jozuern/fw_alarm/(commit log)

2026-06-09 @ BOSS-925 Alarm-Waechter: PlatformIO-Projekt mit Bark-Anbindung
    - Firmware aus Einzel-Sketch in PlatformIO-/Arduino-IDE-kompatible Struktur refaktoriert
    - Secrets nach config.h ausgelagert (gitignored), config.example.h als Vorlage
    - Robustheit: WLAN-Reconnect, pro-Key-Retry, Selbsttest, Watchdog, NTP, optionaler 2. Eingang
    - Ausfuehrliches deutsches README + CLAUDE.md
    @
2026-06-09 @ Alarm-Ton alarm_fw.mp3 hinzufuegen + Import-Anleitung pro iPhone
    - alarm_fw.mp3 (eigener ~30s Sirenenton) ins Repo aufgenommen
    - README: Schritt-fuer-Schritt, wie der Ton in Bark auf JEDEM Empfaenger-iPhone
    importiert wird (Pflicht), inkl. 30s-Limit-Hinweis und Alternative
    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
2026-06-09 @ Umlaute korrigieren + Bark-Texte auf ASCII
    - Echte Umlaute (ä/ö/ü) in .gitignore, platformio.ini und README-Beispielausgabe
    - Bark-Notification kann keine Umlaute anzeigen: ALARM_BODY und Status-/Heartbeat-
    Texte bewusst auf ASCII (ae/ue/oe) umgestellt, mit erklärendem Kommentar
    - Konvention in CLAUDE.md dokumentiert
    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
    [boss925_alarm_bark.ino, config.example.h]
2026-06-17 Probealarm-Fenster: woechentlichen ILS-Test leise quittieren
    Ein Probealarm loest denselben Relaiskontakt aus wie ein echter Alarm.
    Im konfigurierbaren TESTALARM-Fenster (Standard Mi 18:55-19:10) geht daher
    kein lauter Broadcast an alle, sondern nur ein leiser Status-Ping an den
    Owner ("Probealarm erkannt"). inTestWindow() faellt ohne gueltige NTP-Zeit
    auf false zurueck (fail-safe: im Zweifel normal alarmieren).
    - config.example.h: TESTALARM_* Defaults
    - boss925_alarm_bark.ino: inTestWindow() + Gate in loop()
    - CLAUDE.md: Verhalten dokumentiert
    [boss925_alarm_bark.ino, config.example.h]
2026-06-17 README: DIN-Stecker konkretisieren + Pin-Findung per Multimeter
    Hardware-Anschluss praezisiert auf Basis recherchierter Fakten zum
    BOSS-925 / LGRA-Lader:
    - Teileliste: konkreter Bestellbegriff "DIN-Stecker 5-polig 180°
    Loetversion", Schraubklemm-Alternative, Hinweis auf 6-pol Mini-DIN
    bei neueren s.QUAD-Ladern.
    - Verkabelung: Lader-Familie statt nur "LGRA-Expert", Ausloese-
    Bedingung des Relais ergaenzt.
    - Pin-Findung vereinfacht: Pin 1 vs. Pin 3 ist egal (potenzialfreier
    Kontakt); entscheidend ist, die richtigen zwei von fuenf Stiften per
    Multimeter-Durchgangspruefung zu finden (nicht Pin 2/4 erwischen).
2026-07-07 NAS-Dashboard überarbeitet: Direktalarm, Empfängerverwaltung, Härtung
    Dashboard/PHP:
    - REAL ALARM läuft jetzt direkt vom NAS zu Bark (cURL, level=critical,
    pro Key isoliert mit Retry) - unabhängig von der ESP32-Kette.
    - Empfängerliste (Bark-Keys) im Dashboard pflegbar: versioniert in
    alarm_keys.json.php, neues api/keys.php; ESP32 synchronisiert per
    keys_version im Poll und persistiert die Liste im NVS.
    - Pending-Befehle verfallen per TTL (expired) und sind abbrechbar;
    Poll liefert nur aus, wenn der delivered-Zustand persistiert wurde.
    - Laufzeitdateien als *.php mit Guard-Zeile: Nginx (Web Station,
    ignoriert .htaccess) liefert sie nie mehr öffentlich aus.
    - Schreibfehler wer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
2026-07-07 Dashboard: Demo-Modus, Status-Tooltips, Lesebenutzer-Nachzügler
    Demo/Live-Schalter (Panel "Betriebsmodus", nur Admin): Im Demo-Modus gehen
    beide Alarmwege (ESP32-Relaisalarm und NAS-Direktalarm) nur an einen
    Test-Empfänger aus der gepflegten Liste. Ohne Firmware-Änderung umgesetzt:
    demo_mode.json im data_dir, effective_alarm_keys() in common.php speist
    api/keys.php und bark_send_alarm_all(); jeder Moduswechsel erhöht die
    keys_version, der ESP32 holt die Liste beim nächsten Poll. Warn-Banner mit
    Sync-Anzeige (ESP32- vs. NAS-Version), Demo-Empfänger nicht löschbar,
    NAS-Alarm-Body bekommt Zusatz [DEMO-MODUS].
    Statusfelder: ?-Tooltips mit Erklärung an jedem Wert, lesbare Formate
    (Uptime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
2026-07-07 Tooltip-Symbol als schlichtes (?) direkt hinter dem Feldtitel
    Der graue Kreis saß daneben und rutschte in eine eigene Zeile, weil
    ".field span { display:block }" spezifischer war als ".help". Jetzt
    gewinnt ".field span span.help" und das Symbol bleibt inline.
2026-07-07 Demo-Alarm exakt wie echter Alarm: [DEMO-MODUS]-Zusatz entfernt
    Ein Alarm im Demo-Modus soll sich in nichts vom echten unterscheiden
    (gleicher Text, Ton, Level) - nur die Empfaengerliste ist kuerzer.
    Der ESP32-Relaisalarm war ohnehin identisch; jetzt auch der
    NAS-Direktalarm.
2026-07-07 Repo für Veröffentlichung vorbereitet: keine Geheimnisse, MIT-Lizenz
    - Persönliche Empfänger-Onboarding-Anleitung (bark-anleitung.html + PDF)
    aus dem Tracking entfernt und via .gitignore ausgeschlossen (enthielt
    Name und Handynummer des Betreibers).
    - Login-Timing-Schutz-Hash in index.php durch einen frischen Wegwerf-Wert
    ersetzt (Decoy, verifiziert gegen nichts Reales).
    - Interne NAS-IP und Router-Modell aus config.example.h/SETUP.md
    generalisiert (Beispiel-IP 192.168.1.50, "am Router").
    - README aktualisiert: config.h wird aus der Vorlage angelegt (keine
    mitgelieferte config.h mehr behauptet), Demo-Modus, Lese-Benutzer und
    NAS-Offline-Wächter dokumentiert, Sicherheits-/Liz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
2026-07-07 Wächter erweitert: Demo-Erinnerung, Selbstüberwachung, relative Verlaufszeiten
    - cron/check_offline.php erinnert leise per Bark, wenn der Demo-Modus länger
    als demo_reminder_after_seconds (Default 4 h) aktiv bleibt (danach max.
    1x/Tag) - echte Alarme erreichen im Demo-Modus nur den Test-Empfänger.
    - Selbstüberwachung: jeder Wächter-Lauf schreibt last_run_at; das Dashboard
    zeigt "Offline-Wächter: zuletzt gelaufen vor X min" und warnt, wenn die
    DSM-Aufgabe fehlt oder seit >15 min nicht mehr läuft.
    - Verlauf zeigt junge Ereignisse relativ ("vor 5 min", absolute Zeit im
    Tooltip), berechnet mit Server-Zeit statt Browser-Uhr.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
2026-07-08 Bark-Warnung, wenn das NAS das Maschinen-Token ablehnt (HTTP 403)
    Antwortet das NAS auf einen beliebigen API-Aufruf mit 403, geht einmalig
    eine Status-Nachricht an den Owner (BARK_KEY_STATUS). Ohne diese Meldung
    fiel ein falscher Token-Hash in der config.php erst auf, wenn man zufällig
    aufs Dashboard schaute. Nach der nächsten erfolgreichen NAS-Antwort wird
    die Warnung wieder scharf; während alarmPending wird sie zurückgestellt
    (Alarmzustellung hat Vorrang).
2026-07-09 Arbeitsmodus: Stummschaltung pro Empfänger + Verlaufs-/Diagnose-Ausbau
    Kollegen können ihren Empfänger per persönlichem Kurzbefehl-Link
    (api/mute.php?key=<BARK_KEY>&state=on|off, z.B. iPhone-Automation beim
    Betreten/Verlassen der Arbeit) stummschalten: Der Alarm kommt weiterhin
    als Critical Alert an, aber mit volume=0 – lautlos, durchbricht trotzdem
    Stummschalter und Fokus. Beide Alarmwege respektieren das Flag
    (bark_send_alarm_one mit $muted; Firmware über alarmKeyMuted[], Sync via
    muted{i}-Zeilen in api/keys.php, NVS-persistiert, fehlend = laut).
    Sicherheitsnetz: Auto-Unmute nach mute_max_seconds (Default 12 h,
    expire_stale_mutes läuft in mute.php, keys.php, keys_list, vor jedem
    R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
2026-07-09 Sicherheit: data_dir standardmäßig außerhalb des Web-Roots
    Die Laufzeitdateien (u.a. Bark-Keys im Klartext) lagen per Default im
    Web-Root und waren nur durch die .php-Guard-Zeile geschützt - eine
    einzige, zerbrechliche Schicht. config.example.php und SETUP.md empfehlen
    jetzt einen Pfad außerhalb von /volume1/web (bewährt:
    /volume1/web_packages/fw_alarm_data); die Guard-Zeile bleibt als zweite
    Schicht. Live-NAS bereits umgestellt und alter Ordner entfernt.
2026-07-09 Probealarm-Fenster: Alarme mittwochs 18:55-19:05 leiser alarmieren
    Der wöchentliche ILS-Probealarm löst weiterhin den vollen Alarm aus (er
    testet damit die komplette Kette), geht aber nur noch mit halber
    Lautstärke raus: volume=5 statt volume=10. Text, Ton, level=critical und
    call=1 bleiben unverändert.
    Sicherungen gegen versehentlich leise Echtalarme:
    - gilt nur am Probealarm-Wochentag (PROBE_WEEKDAY, -1 = jeden Tag)
    - ohne gültige NTP-Zeit gilt immer die volle Lautstärke
    - die Lautstärke wird einmal bei der Erkennung in pendingVolume
    festgehalten, damit Nachsende-Runden nach Fensterende nicht laut werden
    Stumme Empfänger (Arbeitsmodus) bleiben bei volume=0. Der manuelle
    Dashboa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
2026-07-09 Dashboard: Hinweistexte kürzen
    Die Hinweise unter Empfängerliste, Demo-Modus und Befehls-Knöpfen waren
    sehr lang. Inhaltlich unverändert, nur knapper formuliert.
2026-07-10 Arbeitsmodus-Ausbau: Stumm-Lautstärke, Geheim-Links, Entwarnung, Mobile-UI
    - Stumm-Lautstärke pro Empfänger (0-10, Standard 0 = lautlos): im Dashboard
    einstellbar (keys_set_mute_volume), wirkt auf beide Alarmwege; keys.php
    liefert mutevol{i}, Firmware persistiert sie im NVS (mv{i}, fehlend = 0)
    - Persönlicher Stummschalt-Link jetzt über zufälligen Geheim-Token
    (mute.php?t=..., im Dashboard kopierbar, nur Admin-Rolle); key=-Links
    bleiben gültig; bewusst kein name=-Parameter (erratbar)
    - Bestätigungs-Pushes beim manuellen Stumm-/Lautschalten entfernt; die
    automatische 12-h-Rückschaltung meldet sich weiterhin
    - Neue Buttons: ENTWARNUNG (Fehlalarm, normale Push an alle, level=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
2026-07-11 Dashboard-Audit 1/4: Inhalt & Informationsarchitektur
    - Box offline: Statuswerte werden grau gedimmt + Hinweiszeile "letzter
    bekannter Stand von ..." (stale Werte sahen bisher live aus); die
    weiterhin gültigen Zeilen (Offline seit, NAS-Wächter) behalten Farbe.
    - Alarm-/Entwarnungs-Ergebnis zeigt Empfänger-NAMEN statt maskierter
    Keys ("Josh FEHLER" statt "abc... FEHLER") - unter Stress zählt, wer
    fehlt. label läuft durch effective_alarm_entries() in beide Sender.
    - Offline-Wächter: Normalzustand als eigene Statuszeile in "Box &
    Wartung"; im Hero erscheint nur noch der Warnfall (weniger Rauschen).
    - Betriebsmodus-Panel in "Auslösen & Testen" integriert (Demo-Modus ist
    ein Te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
2026-07-11 Dashboard-Audit 2/4: UX-Fixes
    - iOS-Zoom-Fix: Eingabefelder und Selects mindestens 16px Schrift -
    Safari zoomt sonst beim Fokussieren die ganze Seite heran (Login,
    Empfänger hinzufügen, Lautstärke-Auswahl).
    - Netz-Schluckauf wirft Empfängerliste/Verlauf nicht mehr weg: Bei
    Fetch-Fehlern bleibt der letzte bekannte Stand stehen (sah vorher
    nach Datenverlust aus); Fehlertext nur, wenn noch nie geladen.
    - Wettrennen behoben: Das 5-s-Polling aktivierte den Demo-Umschalter
    wieder, während eine Aktion noch lief (actionBusy-Merker).
    - Verlauf: "Ältere Ereignisse anzeigen" lädt in 25er-Schritten bis 100
    nach (log_view mit gedeckeltem limit-Parameter).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
2026-07-11 Dashboard-Audit 4/4: Design-Tokens konsolidieren
    - Typo-Skala auf ganze Stufen (11/12/13/14/15/16) als --fs-*-Tokens;
    die alten Zwischenstufen 12,5/13,5 waren optisch nicht unterscheidbar.
    - Signal-Ableitungen als Tokens (--warn-bg/-line, --crit-bg/-line,
    --ok-line) statt gestreuter rgba-Werte; nahe Alphas (0,07-0,12)
    vereinheitlicht - wer eine Signalfarbe ändert, ändert alles mit.
    - Radius-Tokens --r-panel/--r-ctl/--r-pill.
    - Bewusst NICHT tokenisiert: Lampen-Glow-Schatten, ::selection,
    Hover-Verstärkungen, 26px-Markentitel, 50%-Kreise (Einzelstücke ohne
    Wiederverwendung) und die Mikro-Abstände (gewachsener 2px-Rhythmus,
    ein 4er-Raster hätte das Layout sichtbar verschoben)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
